AdityaAdusumalli8/SeniorDesignProject---Automated-Irrigation-System/notebooks/adityaa8/image1.png

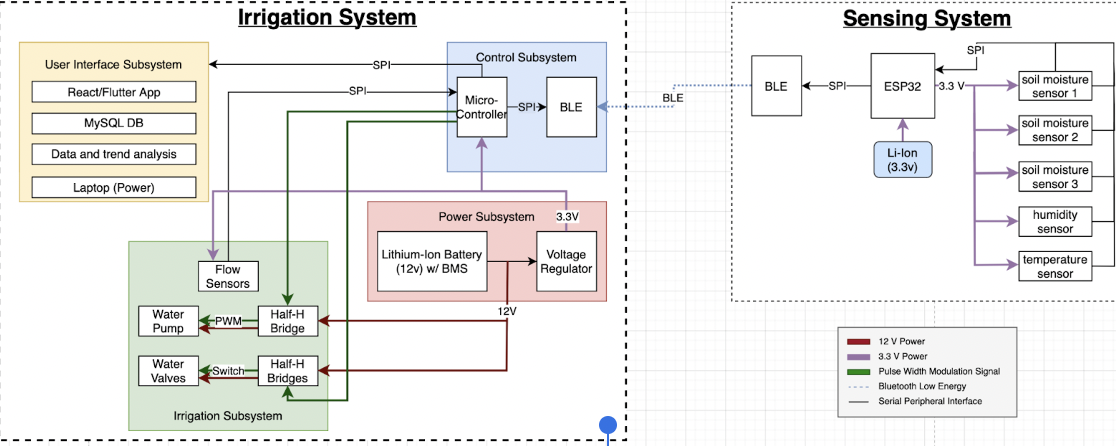
notebooks/adityaa8/image1.png
