AdityaAdusumalli8/SeniorDesignProject---Automated-Irrigation-System/notebooks/adityaa8/image3.png

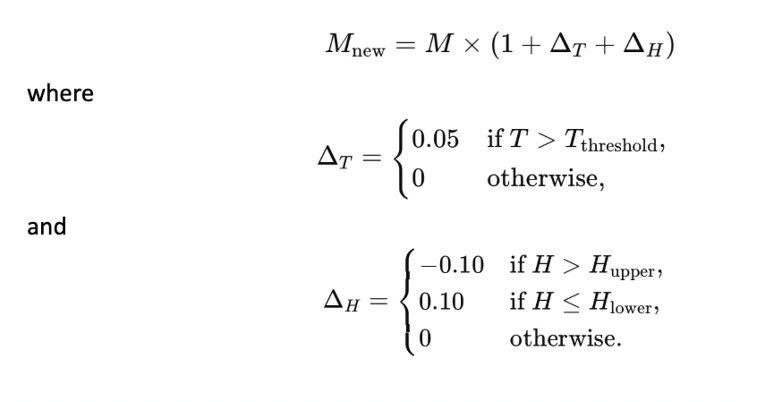
notebooks/adityaa8/image3.png
