AdityaAdusumalli8/SeniorDesignProject---Automated-Irrigation-System/notebooks/adityaa8/image4.png

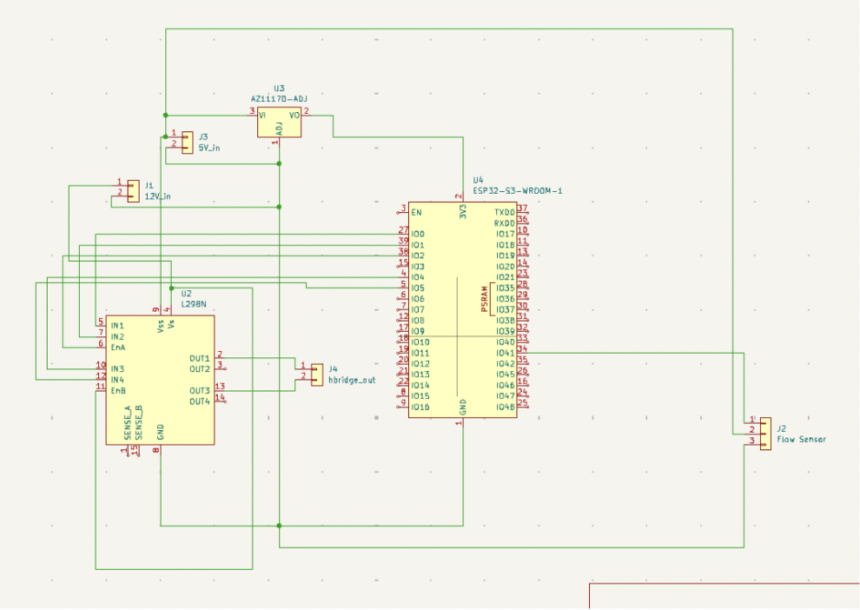
notebooks/adityaa8/image4.png
