AdityaAdusumalli8/SeniorDesignProject---Automated-Irrigation-System/notebooks/adityaa8/image5.png

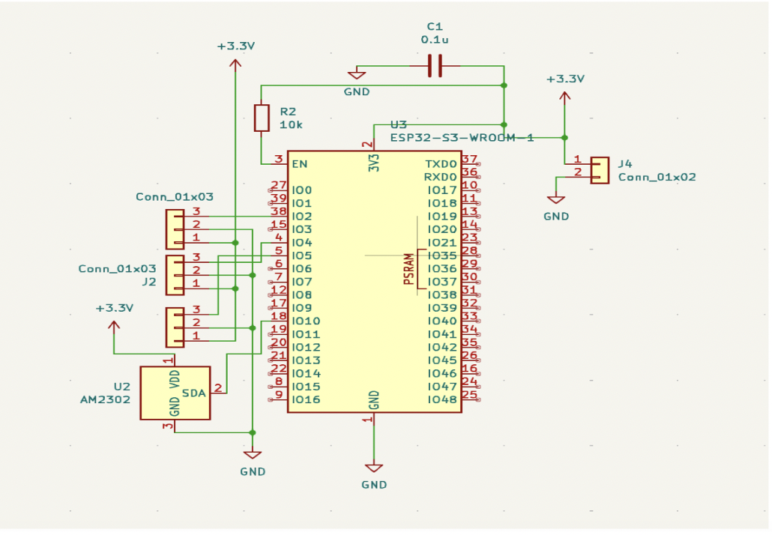
notebooks/adityaa8/image5.png
