AdityaAdusumalli8/SeniorDesignProject---Automated-Irrigation-System/notebooks/adityaa8/image6.png

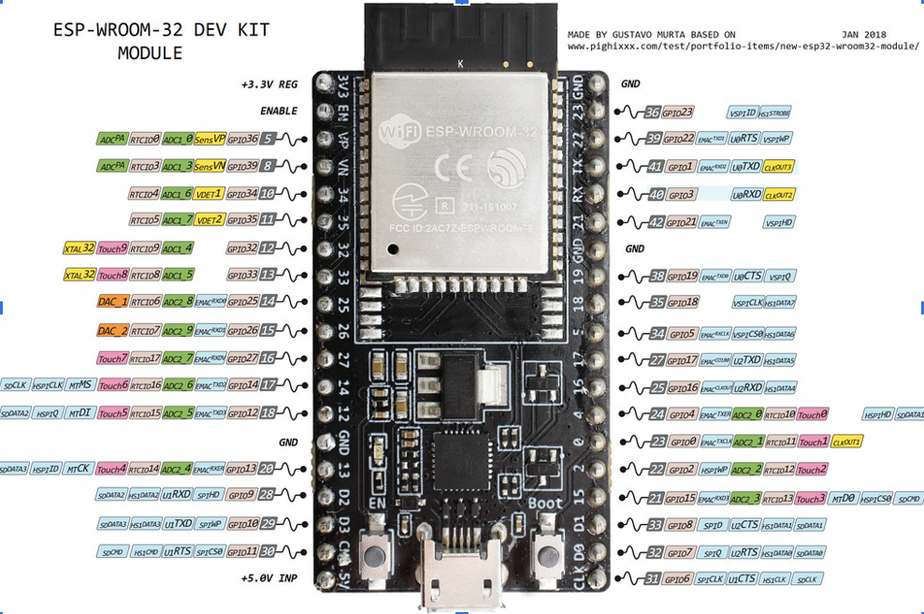
notebooks/adityaa8/image6.png
