AdityaAdusumalli8/SeniorDesignProject---Automated-Irrigation-System/notebooks/adityaa8/image7.png

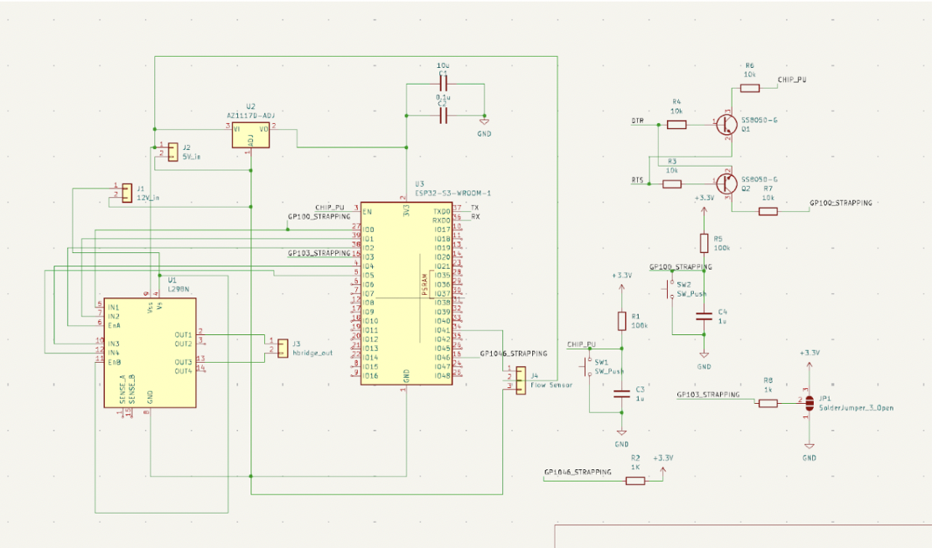
notebooks/adityaa8/image7.png
