AdityaAdusumalli8/SeniorDesignProject---Automated-Irrigation-System/notebooks/adityaa8/image8.png

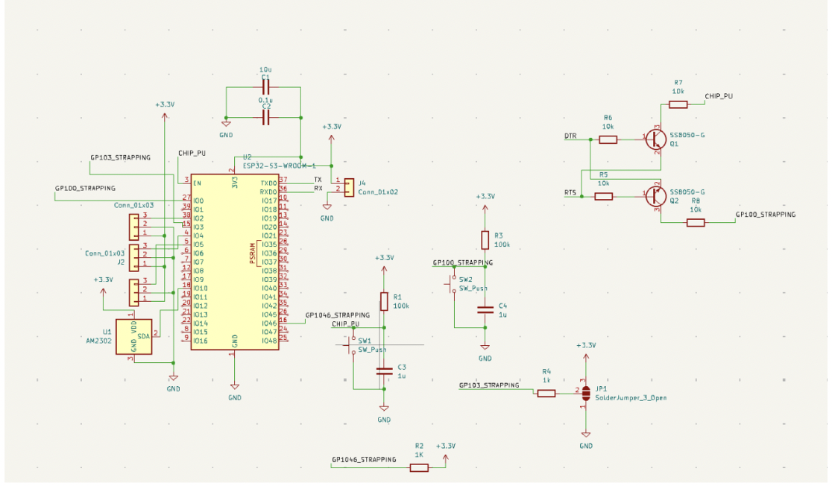
notebooks/adityaa8/image8.png
